diy-fluorometer/aolw2018-capetown/README.md

This repository holds everything we've done at the Advanced Open Labware Workshop, April 16 through April 27th in Capetown, South Africa
