diy-fluorometer/aolw2018-capetown/case/cad_files/README.md

All CAD files for the device case are stored here.

The design currently consists essentially of two nested boxes - an outer case that ensures light isolation, the inner case is where the LED, sensor, and LED are attached, and where the tube containing the sample will be inserted.
