diy-fluorometer/aolw2018-capetown/daily_reports/Day_08_2018-04-24.md

# Plan for the day

* Ale: Keep working on assembly instructions
* Lisa: Figure out bug in TSL2591 sensor code and fix it
* Do measurements with DNA ladder + fluorescent dye

# What we did today

## Bug in TSL2591 sensor code

The TSL2591 sensor offers four different gain settings:

| LOW    | 1x    |
| MEDIUM | 25x   |
| HIGH   | 428x  |
| MAX    | 9876x |

If there is very little light, the sensor might fail to return a value at the gain setting LOW, but a useable value at gain setting HIGH, for example. Under most conditions, the sensor returns useable values at several gain settings.
For example, when measuring with just the empty sensor box, we get the following values:

| Value | Gain level |
| -----:| --- |
| 14563 | MAX |
| 631 | HIGH |
| 37 | MED |
| 1 | LOW |

I thought it desirable to map the readings to a single scale, namely the one associated with the MAX gain setting. It turned out that the way I was trying to do that was wrong, hence the strange sensor readings. There's also not an easy fix, because there is no way you can map a value obtained at gain level LOW to a precise value on the MAX scale. Any value at LOW would map to entire range of values on the MAX scale.
So for today's measurements, I settled for recording the readings at all gain settings for each measurement and then sort through that data during the analysis stage.
One option would be to use the Lux calculation from the [Adafruit TSL2591 sensor library](https://github.com/adafruit/Adafruit_TSL2591_Library/blob/master/Adafruit_TSL2591.cpp). We can still do that later based on the data we have.
Note that we only record the data from the sensor's Channel 0 (IR+Visible), and ignore Channel 1 (IR).

## Measurements with DNA ladder + fluorescent dye

## Pulsing LED / Cellphone-only approach

Since the measurements with the textmarker where promissing we assembled the circuit described on day 5 withing an old fluorometer-housing. 
to measure the dilution series Roberts cell phone (Huawei P10) was connected to the "Cell-phone-only-fluorometer". To play the frequency the LED is modulatred with we used the signal generator app:(https://play.google.com/store/apps/details?id=com.xyz.signal). It can keep playing even if an other app is opened (see settings). 
The frequency was randomly chosen to be 479 Hz and therefore not coincide with overtones of the power grid. We used a sine since it appaered to have a slightly better signal to noise ratio.

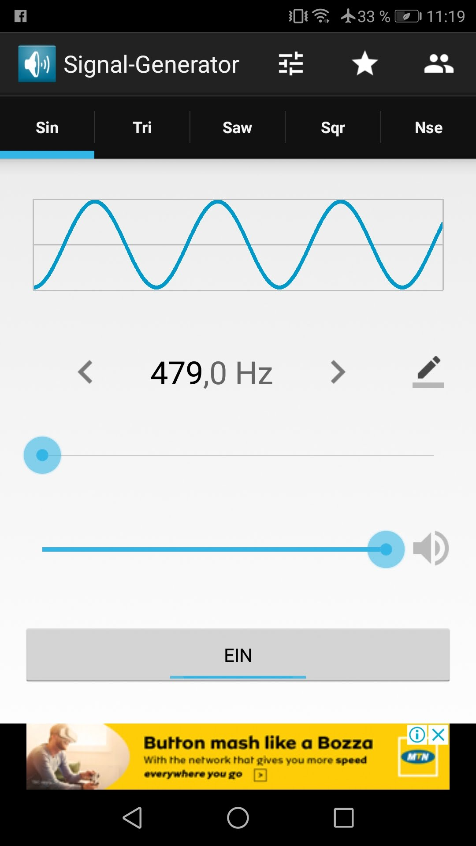
[picture p3: sketches/Screenshot_20180425-111908.jpg]
settings in the signal generator app to modulate the LED


To measure the Signal we used the FFT app: (https://play.google.com/store/apps/details?id=org.intoorbit.spectrum)

The seettings where chosen as seen in the screenshot:

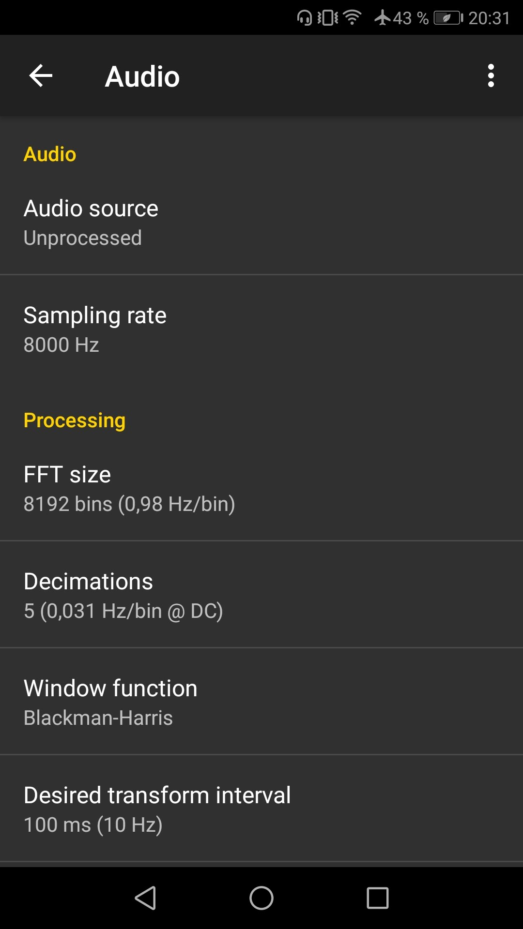
[picture p4: sketches/Screenshot_20180423-203127.jpg]
settings in the spectroid app to meassure the fluorescence signal


The dilution series was measured in total 6 times. Inbetween m1 and the rest of the measurements i dissassembled the setup and pulsed the LED with an Arduino. I thought this would improve the SNR. However it did not and instead the signal was fluctuating much more. I still have to figure out why.
I changed the setup to the initial conditions and tried to replicate the results of m1. I also took 5 values (m2-m6) to get a grasp of the fluctuations of the values. 

DNA ledders / µl | DNA ledders staing in tube / µl | DNA concentration µg/ml | initial H2O | Dye stock | total DNA in 50 µl/ ng | m 1 | m2 | m3 | m4 | m5 | m6 | m ard
 ---:  |  ---  |  ---  |  ---  |  ---  |  ---  |  ---  |  ---  |  ---  |  ---  |  ---  |  ---  |  --- 
80 | 40 | 160 | 0 | 10 | 8000 | -38.8067 | -38.6284 | -38.629 | -38.6422 | -38.6216 | -38.6246 | -13.882
40 | 20 | 80 | 40 | 10 | 4000 | -40.9717 | -40.6646 | -40.6417 | -40.6131 | -40.5897 | -40.5588 | -15.297
20 | 10 | 40 | 40 | 10 | 2000 | -42.8331 | -42.9878 | -42.9663 | -42.9723 | -42.9769 | -42.986 | -17.11
10 | 5 | 20 | 40 | 10 | 1000 | -43.9894 | -44.1098 | -44.1039 | -44.1069 | -44.108 | -44.1125 | -18.18
5 | 2.5 | 10 | 40 | 10 | 500 | -44.6641 | -44.6472 | -44.645 | -44.6418 | -44.643 | -44.6411 | -18.582
2.5 | 1.25 | 5 | 40 | 10 | 250 | -44.4905 | -44.5315 | -44.5255 | -44.5245 | -44.5232 | -44.5224 | -18.15
1.25 | 0.625 | 2.5 | 40 | 10 | 125 | -44.7322 | -44.6136 | -44.6188 | -44.6145 | -44.6128 | -44.6062 | -18.485
0.625 | 0.3125 | 1.25 | 40 | 10 | 62.5 | -44.7334 | -44.5895 | -44.5834 | -44.5792 | -44.5808 | -44.5798 | -18.394
0 | 0 | 0 | 40 | 10 | 0 | -44.9721 | -44.772 | -44.7697 | -44.7715 | -44.7713 | -44.7726 | -18.629

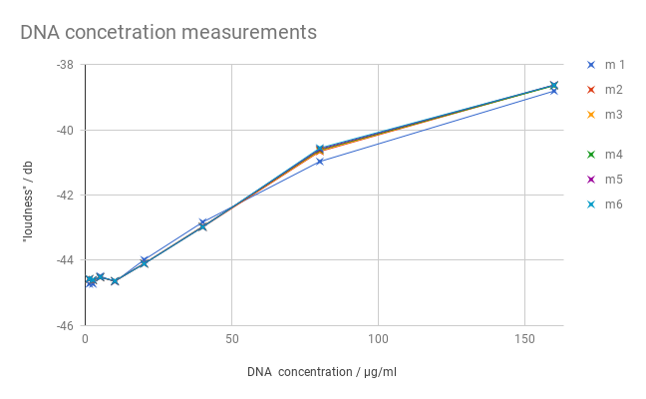
[picture p5: sketches/chart_dna_cell.png]
loudnes of the 479 Hz peak in dependence of the DNA concentration


Replicating worked well and the fluctuations are negligible.

The approach with the arduino should have given a better SNR. Indeed the max value of the peak was much higher. However it also  introduced signal fluctuations.
