diy-fluorometer/aolw2018-capetown/daily_reports/Day_09_2018-04-25.md

# Plan for the day

* Ale: Finish assembly instructions
* Lisa & Robert: Yesterday's documentation
* Analyze data from yesterday's measurements
* Do measurements of yesterday's samples with other filters
* Do measurements with other dyes: dsGreen, Pico488

# What we did today

## Small tasks

* Added BOM to repo

## Lessons learned / Observations / Future work

* Case use notes -> redesign
* Lambda DNA instead of DNA ladder?
* Buffer?
* Method for making the standard?
* Calibrating with text marker dye?
* Improve the circuit for the cellphone version
* Measure filters
* Improve NodeMCU code version
* DNA extraction & measurement of actual DNA
