diy-fluorometer/aolw2018-capetown/daily_reports/Day_06_2018-04-21.md

# Plan for the day

Today is only a half-day, so the task list is a bit shorter:

* Lisa will continue to work on the NodeMCU code
* Robert will continue to work on the cellphone-only version
* Editing photos from the assembly photo series; write out assembly instructions
* Robert: Cut glass filters
