diy-fluorometer/aolw2018-capetown/notes/use_notes.md

# Things we noticed while using the prototype

The design as it is is quite awkward. We already knew it's unnecessarily huge, but the sample holder is also positioned too low, which makes it awkward to put in the sample tubes, and to get them out again.
Desperately needs a redesign.
