diy-fluorometer/aolw2018-capetown/case/cad_files/IMPORTANT NOTE FOR LASERCUTTING.txt

Inkscape puts the line to cut a the border of the line.
Thus, to lasercut precuisely, you need to have lines of width 0.

The setup:
View -> display mode -> outline
