diy-fluorometer/aolw2018-capetown/docs/DNA_Quantification_Using_SYBR_Green_and_a_Micro-Plate_Reader.pdf

Purpose

To quantify purifi ed total double-stranded (ds) DNA by fl uorescence.

Equipment and Reagents

Equipment

1. Micro-plate reader (e.g. TECAN - M200 96-well plate reader).

Materials

1. 96-well black plate (e.g. Greiner – 96-well plate, black. VWR cat # 82050-784).

Reagents

1. 1x TE (10mM Tris HCI, 1mM• EDTA, pH8).
(i) Store at room temperature.
2. SYBR Green I dye (Invitrogen cat # S7563).
i) 100x working stock prepared by diluting 10 μL of SYBR Green dye with 990 μL TE buff er. ii) Store in 10 or 20 μL aliquots in 0.2 mL PCR tubes at -20°C.
iii) Before each use, thaw at room temperature.
3. dsDNA for Standard Curve – Lambda DNA (Invitrogen cat # 25250-010).
i) Serially dilute the DNA to give a total of 7 dilutions plus a no-DNA point.
ii) 50 μl aliquots of each standard are stored in 0.2 mL PCR tubes at - 20ºC (See table 2. Standards A-H). iii) Th aw one tube of each standard.

Procedure

### 1. Preparation of Master Mix

i) Prepare a master mix solution, suffi cient for all tubes to be assayed.

## DNA Quantifi cation Using SYBR Green I Dye and a Micro-Plate Reader

| Volume (μL) | 20 + n n=number of unknown samples
TE | 94
100X SYBR Green 1 | 1
Total | 95

Table 1.

### 2. Standard Curve:

i) For each standard (A-H):
(a) In duplicate, add 5 μL of each standard to a well of a black 96-well plate.
(b) Add 95 μl of the master mix to each well.

### 3. Unknown Purifi ed Saliva Samples

i) For each unknown sample(n):
(a) Dilute purifi ed DNA 1:50 in 1x TE (4 μL sample + 196 μL 1x TE).
(b) Add 5 μL of unknown sample to a well of a black 96-well plate.
(c) Add 95 μL of Master Mix.

### 4. Read Fluorescence of Samples

(a) Excitation 485 nM.
(b) Emission 535 nM.

### Safety and Environmental Information

Th e use of gloves is required to avoid sample contamination.

### END OF PROCEDURE

PD-PR-075 Issue 1.0
info@dnagenotek.com
Tel.: (613)723-5757
Standard | Concentration (ng/μl) | Volume (μl) | Total DNA (ng)
A | 10.0 | 5 | 50.0
B | 5.0 | 5 | 25.0
C | 2.51 | 5 | 12.5
D | 1.25 | 5 | 6.25
E | 0.625 | 5 | 3.12
F | 0.3125 | 5 | 1.56
G | 0.156 | 5 | 0.78
H | 0.0 | 5 | 0.0
Table 2.
