diy-fluorometer/aolw2018-capetown/analysis/chart_cell_arduino.png

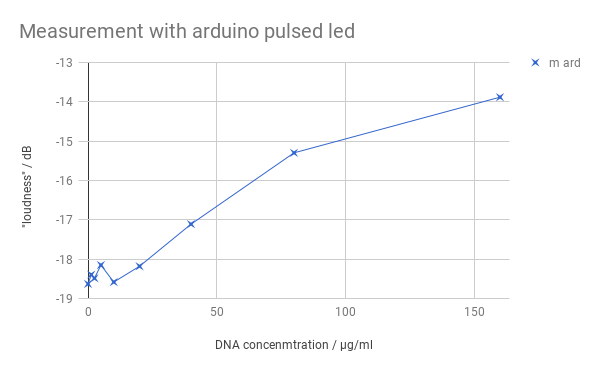
analysis/chart_cell_arduino.png
