diy-fluorometer/aolw2018-capetown/analysis/DNA_cheek_cell.png

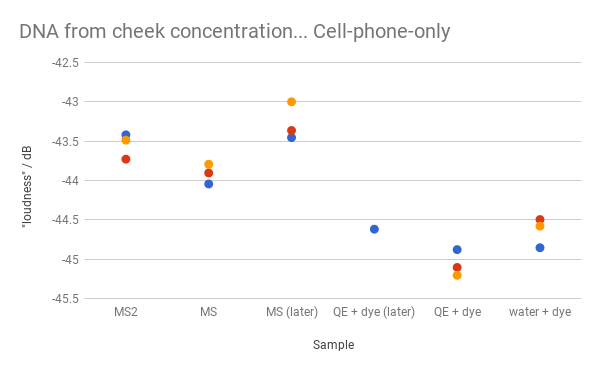
analysis/DNA_cheek_cell.png
