diy-fluorometer/aolw2018-capetown/daily_reports/photos/P1030807.JPG

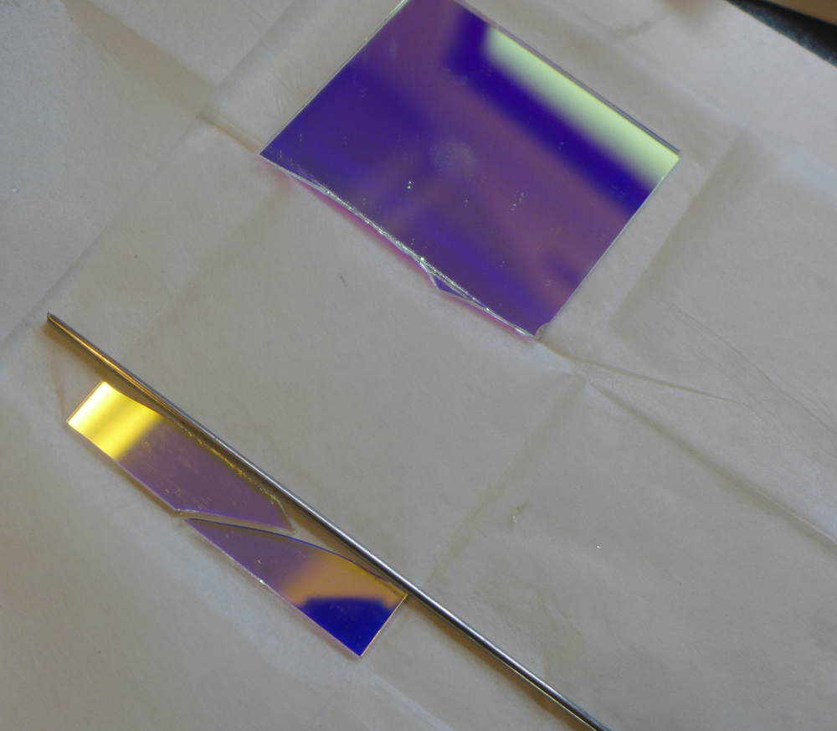
daily_reports/photos/P1030807.JPG
