diy-fluorometer/aolw2018-capetown/daily_reports/photos/P1030809.JPG

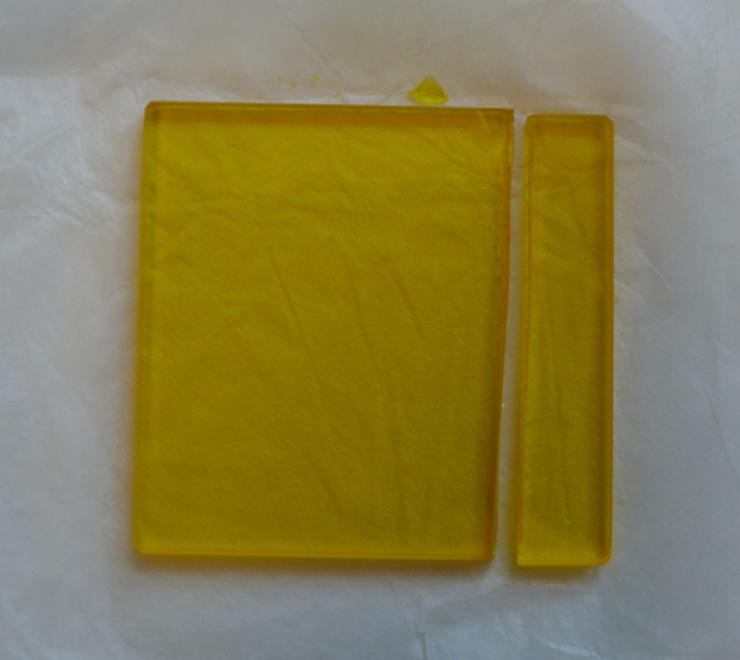
daily_reports/photos/P1030809.JPG
