diy-fluorometer/aolw2018-capetown/daily_reports/photos/P1030810.JPG

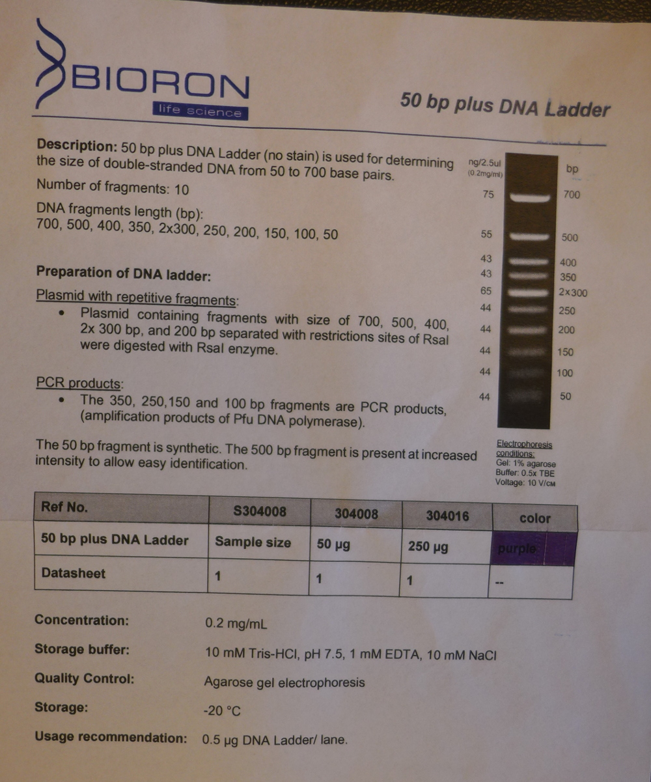
daily_reports/photos/P1030810.JPG
