diy-fluorometer/aolw2018-capetown/daily_reports/photos/P1030812.JPG

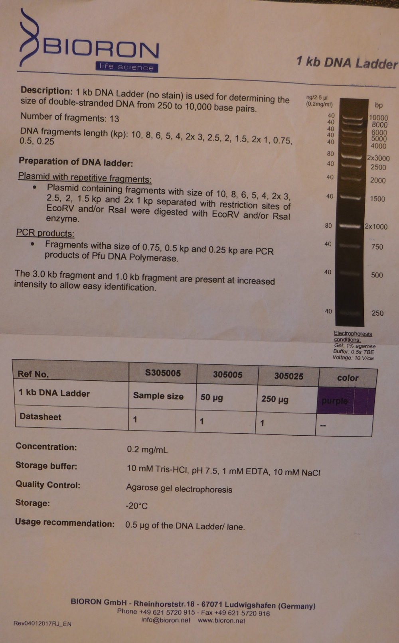
daily_reports/photos/P1030812.JPG
