diy-fluorometer/aolw2018-capetown/daily_reports/photos/P1030813.JPG

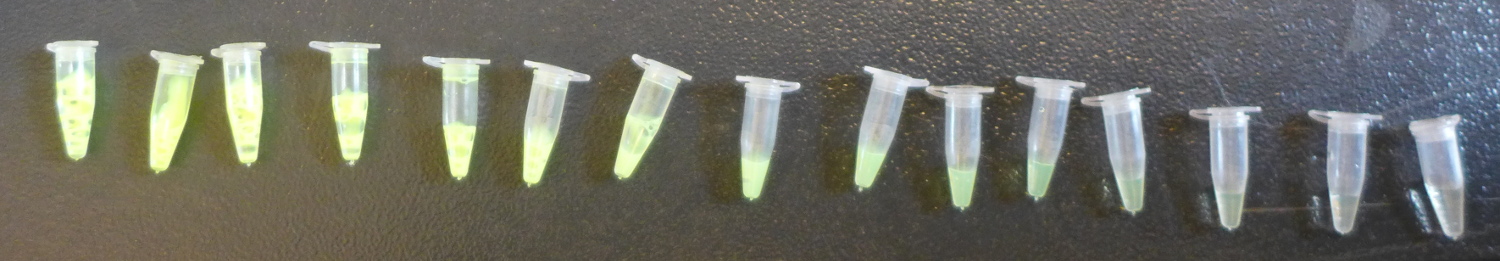
daily_reports/photos/P1030813.JPG
