diy-fluorometer/aolw2018-capetown/docs/assembly/edited/overview.JPG

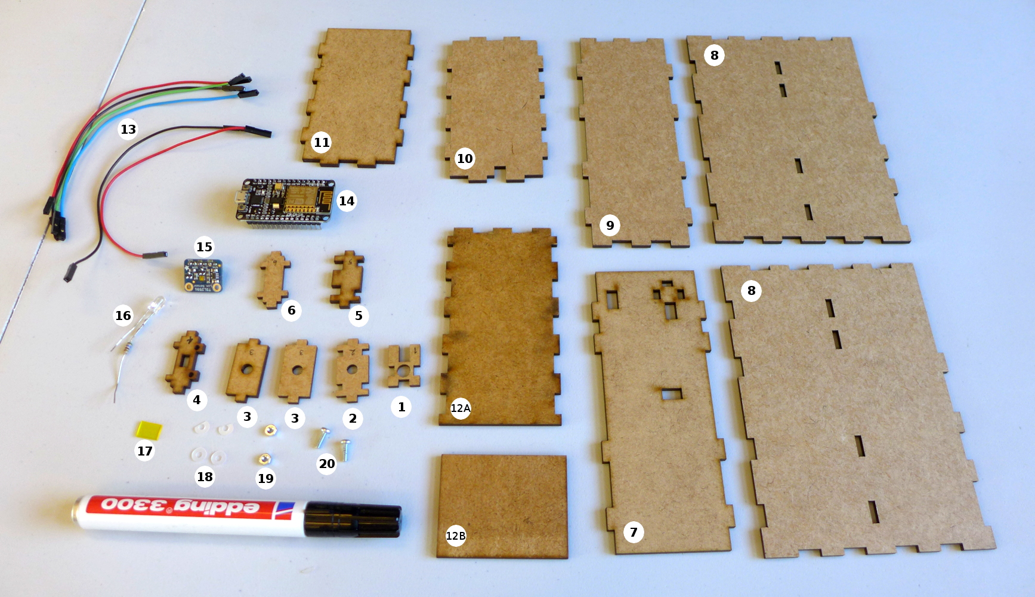
docs/assembly/edited/overview.JPG
