diy-fluorometer/aolw2018-capetown/docs/TSL2591_dimensions.png

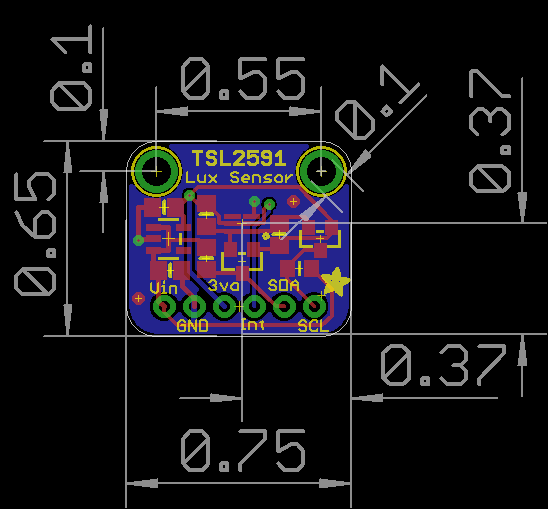
docs/TSL2591_dimensions.png
