diy-fluorometer/aolw2018-capetown/docs/TSL2591_NodeMCU_schem.png

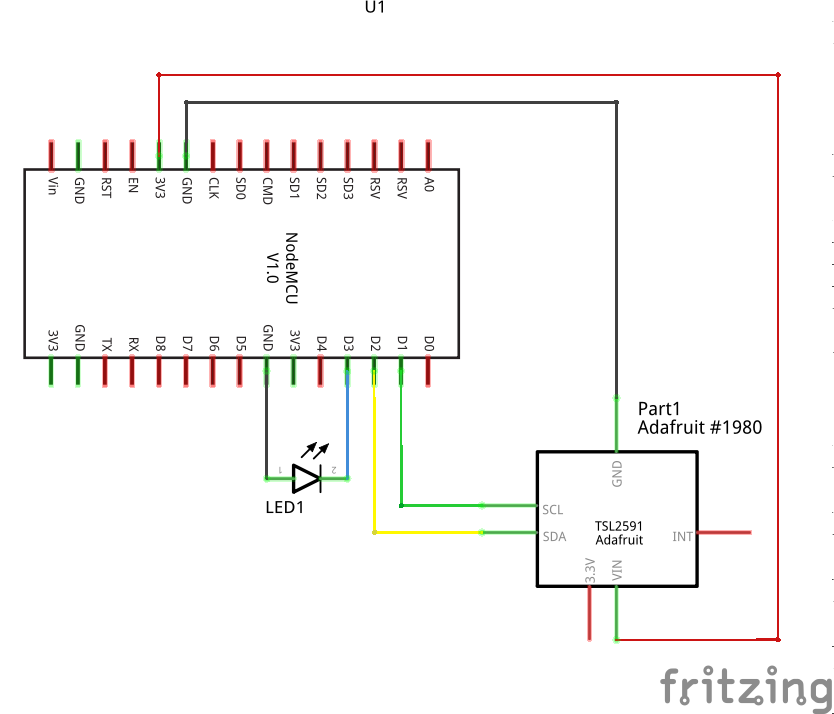
docs/TSL2591_NodeMCU_schem.png
