diy-fluorometer/aolw2018-capetown/sketches/IMG-20180513-WA0001.jpg

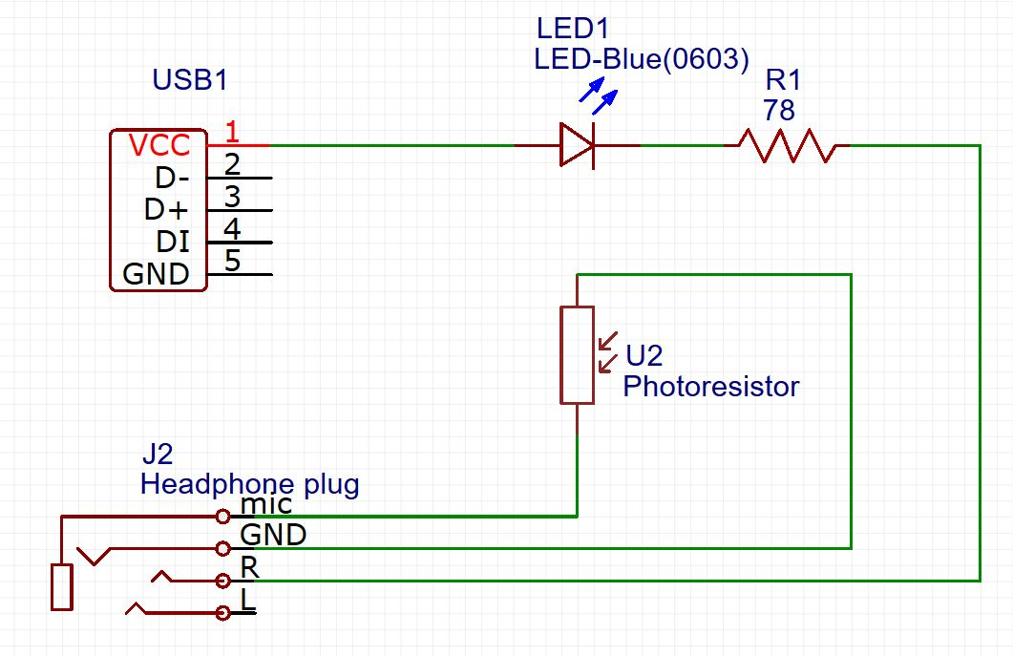
sketches/IMG-20180513-WA0001.jpg
