diy-fluorometer/aolw2018-capetown/sketches/IMG_20180427_130239.jpg

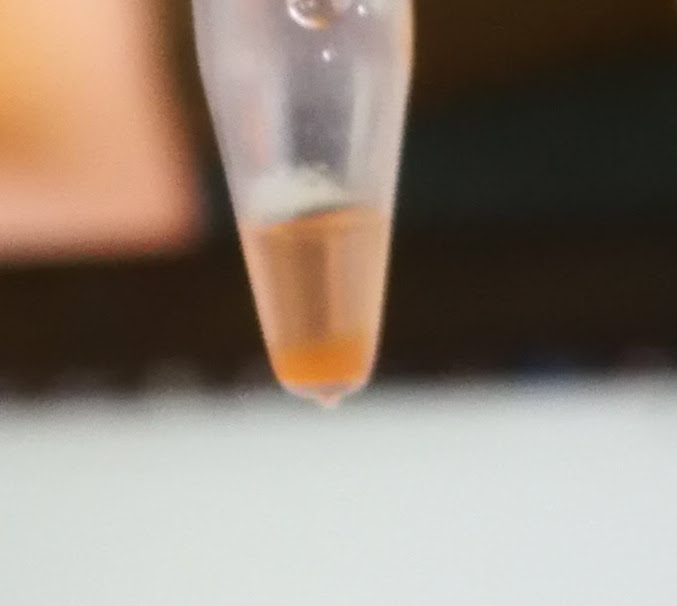
sketches/IMG_20180427_130239.jpg
