diy-fluorometer/aolw2018-capetown/case/cad_files/v5/test3_sub4.dxf

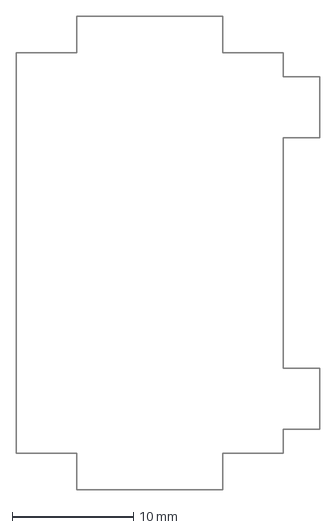
[picture p23: CAD file, 2018-07-02]
case/cad_files/v5/test3_sub4.dxf
25.0 x 39.0 mm
