diy-fluorometer/aolw2018-capetown/case/cad_files/v5/test3_sub.dxf

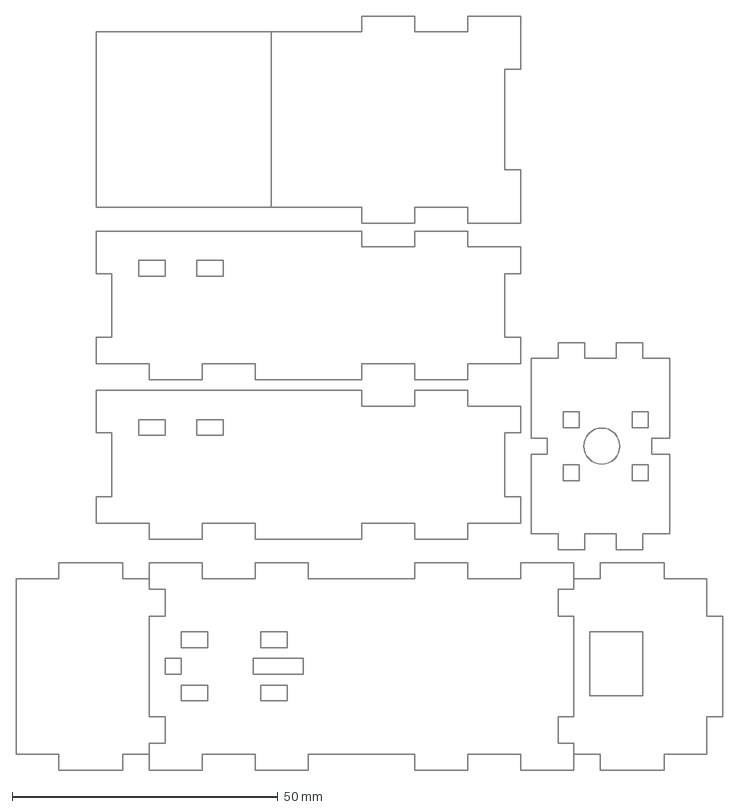
[picture p24: CAD file, 2018-07-02]
case/cad_files/v5/test3_sub.dxf
133.0 x 142.0 mm
