diy-fluorometer/aolw2018-capetown/case/cad_files/v5/test2_mod1.dxf

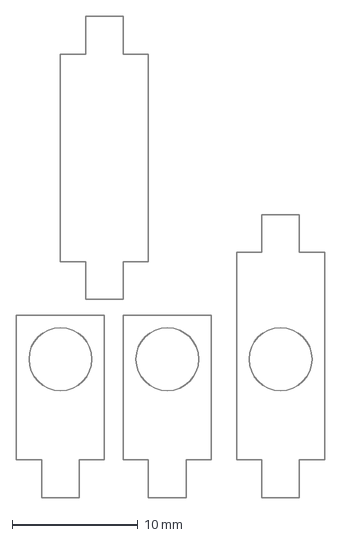
[picture p25: CAD file, 2018-07-02]
case/cad_files/v5/test2_mod1.dxf
24.5 x 38.2 mm
