diy-fluorometer/aolw2018-capetown/case/cad_files/v5/test3_sub2.dxf

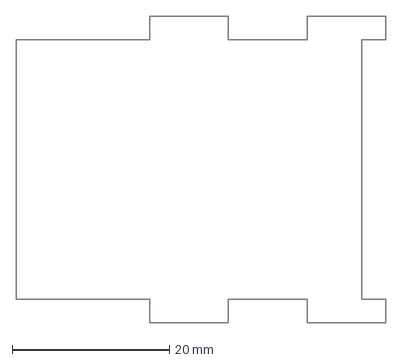
[picture p26: CAD file, 2018-07-02]
case/cad_files/v5/test3_sub2.dxf
47.0 x 39.0 mm
