diy-fluorometer/aolw2018-capetown/case/cad_files/v5/test3.dxf

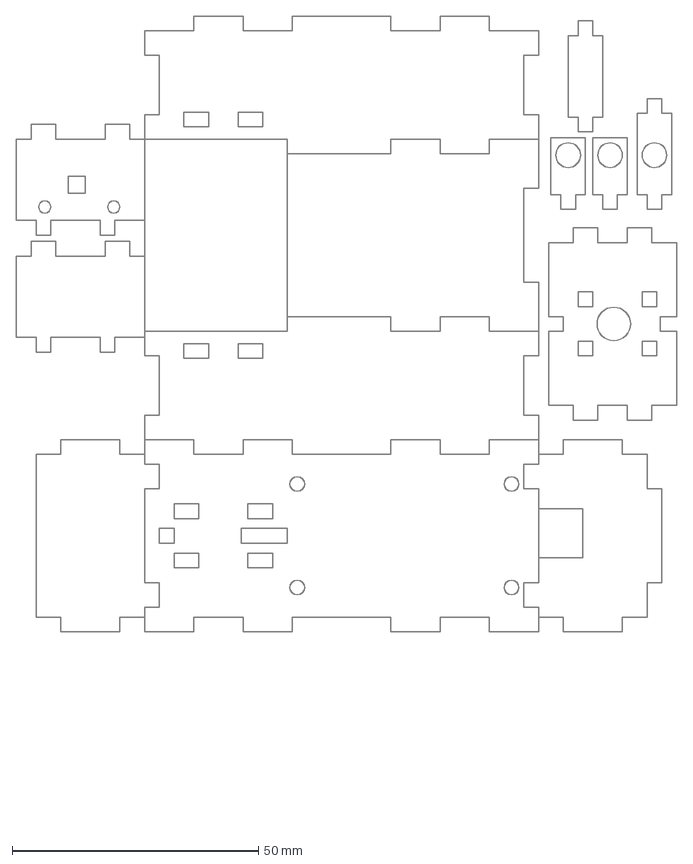
[picture p27: CAD file, 2018-07-02]
case/cad_files/v5/test3.dxf
134.0 x 164.0 mm
