diy-fluorometer/aolw2018-capetown/case/cad_files/v5/test3m.dxf

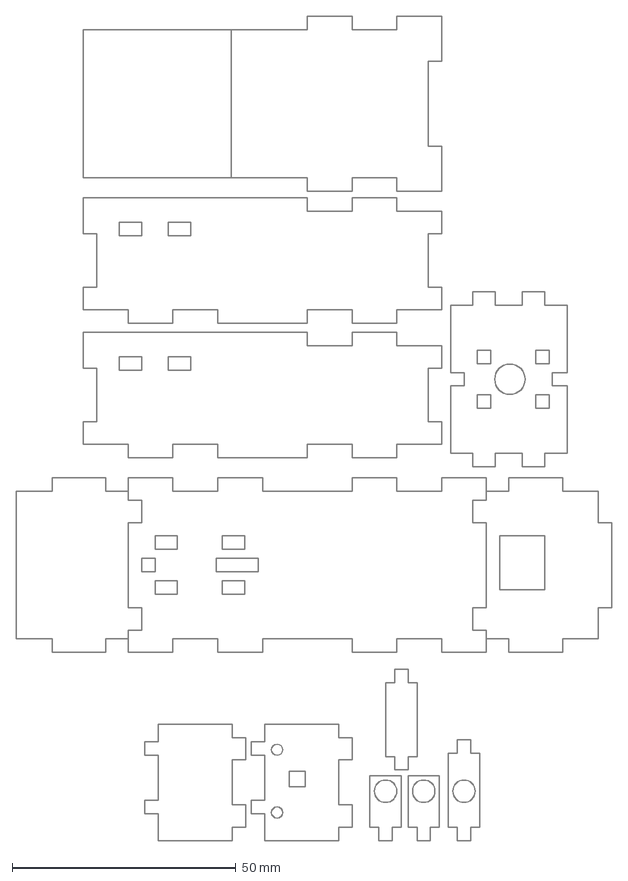
[picture p28: CAD file, 2018-07-02]
case/cad_files/v5/test3m.dxf
133.0 x 184.0 mm
