diy-fluorometer/aolw2018-capetown/case/cad_files/v5/test1.dxf

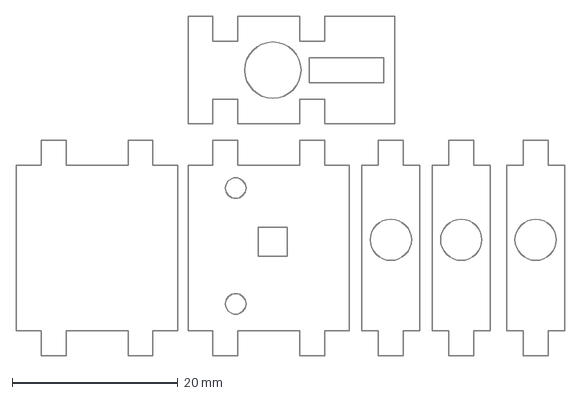
[picture p29: CAD file, 2018-07-02]
case/cad_files/v5/test1.dxf
66.2 x 41.0 mm
