diy-fluorometer/aolw2018-capetown/case/cad_files/v5/test2.dxf

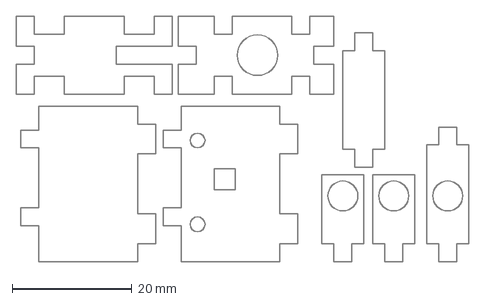
[picture p30: CAD file, 2018-07-02]
case/cad_files/v5/test2.dxf
75.5 x 41.0 mm
