diy-fluorometer/aolw2018-capetown/case/cad_files/v5/test3_sub3.dxf

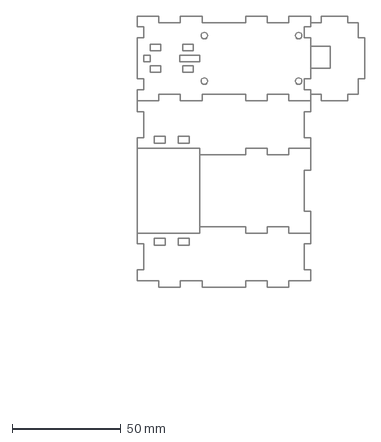
[picture p31: CAD file, 2018-07-02]
case/cad_files/v5/test3_sub3.dxf
160.7 x 177.8 mm
