diy-fluorometer/aolw2018-capetown/case/cad_files/v5/test3_sub5.dxf

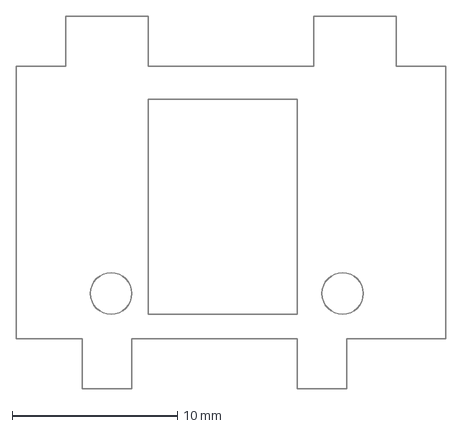
[picture p32: CAD file, 2018-07-02]
case/cad_files/v5/test3_sub5.dxf
26.0 x 22.5 mm
