diy-fluorometer/aolw2018-capetown/case/cad_files/v4/add_7.dxf

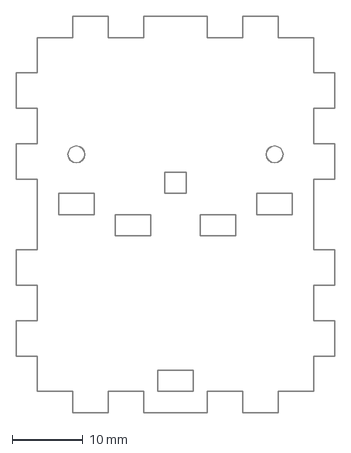
[picture p33: CAD file, 2018-05-15, an earlier design]
case/cad_files/v4/add_7.dxf
45.0 x 56.0 mm
