diy-fluorometer/aolw2018-capetown/case/cad_files/v4/add_5.dxf

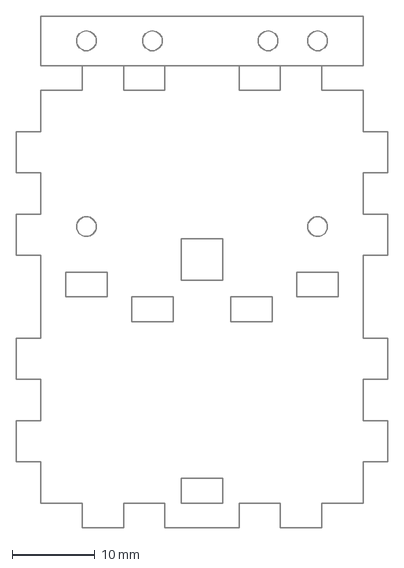
[picture p34: CAD file, 2018-05-15, an earlier design]
case/cad_files/v4/add_5.dxf
45.0 x 62.0 mm
