diy-fluorometer/aolw2018-capetown/case/cad_files/v4/v4_1.dxf

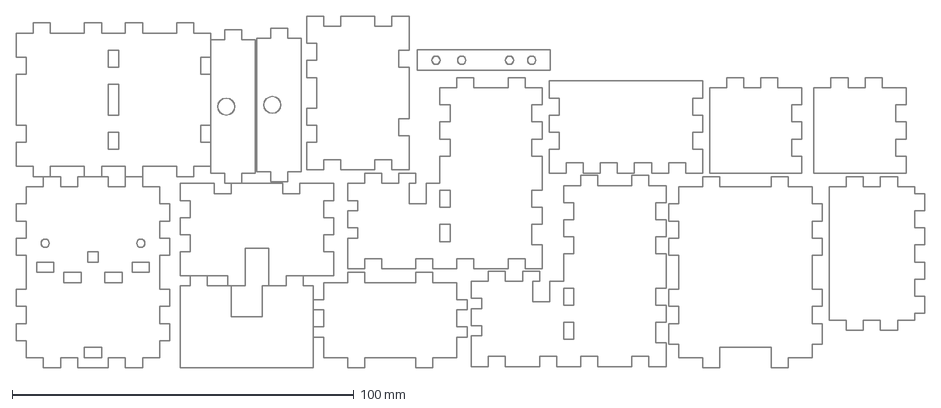
[picture p35: CAD file, 2018-05-15, an earlier design]
case/cad_files/v4/v4_1.dxf
266.0 x 103.0 mm
