diy-fluorometer/aolw2018-capetown/case/cad_files/v4/add_6.dxf

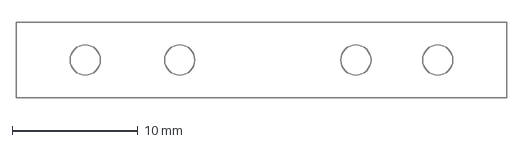
[picture p36: CAD file, 2018-05-15, an earlier design]
case/cad_files/v4/add_6.dxf
39.0 x 6.00 mm
