diy-fluorometer/aolw2018-capetown/case/cad_files/v4/cuvette_bodyx3.dxf

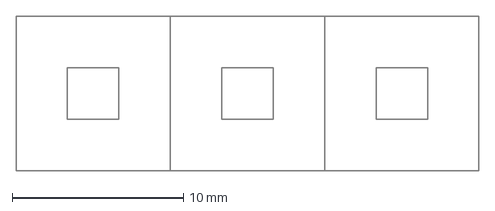
[picture p38: CAD file, 2018-05-13, an earlier design]
case/cad_files/v4/cuvette_bodyx3.dxf
27.0 x 9.00 mm
