diy-fluorometer/aolw2018-capetown/case/cad_files/v4/add_2.dxf

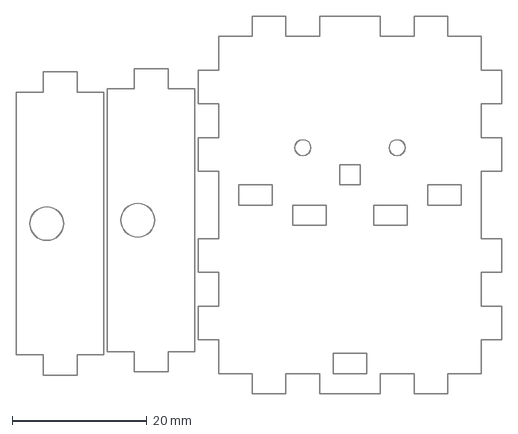
[picture p39: CAD file, 2018-05-13, an earlier design]
case/cad_files/v4/add_2.dxf
72.0 x 56.0 mm
