diy-fluorometer/aolw2018-capetown/case/cad_files/v4/cuvette_basex20.dxf

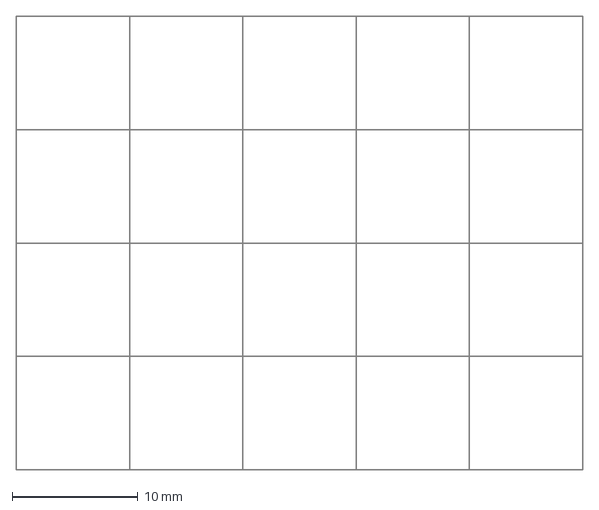
[picture p40: CAD file, 2018-05-13, an earlier design]
case/cad_files/v4/cuvette_basex20.dxf
45.0 x 36.0 mm
