diy-fluorometer/aolw2018-capetown/(list of files, cad)

Other CAD files:
case/cad_files/v4/v4.scad
case/cad_files/v4/add.dxf
