diy-fluorometer/aolw2018-capetown/docs/assembly/edited/P1030792.JPG

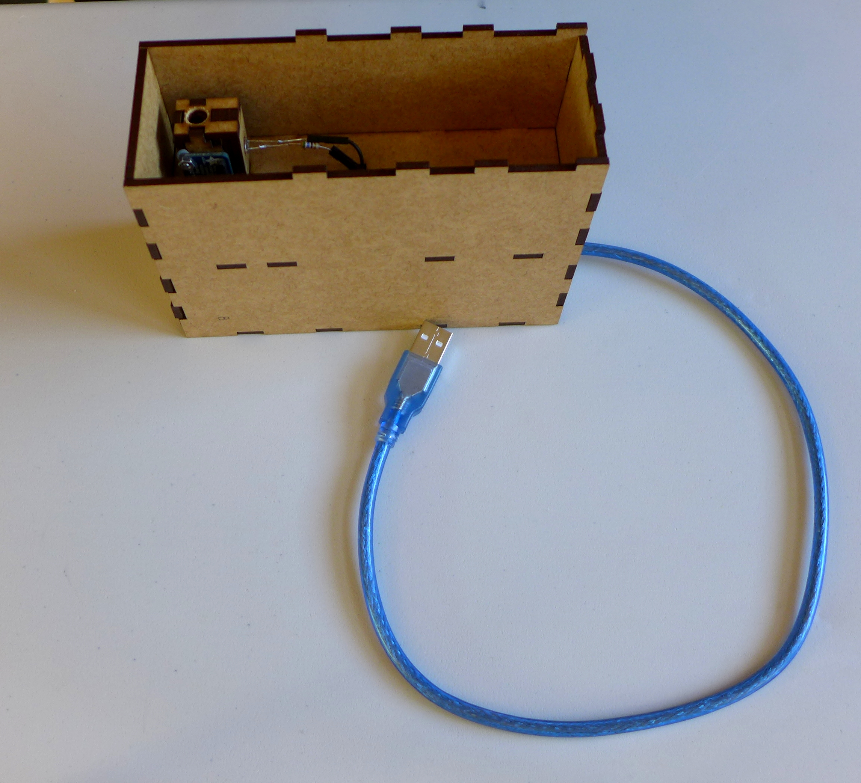
docs/assembly/edited/P1030792.JPG
