diy-fluorometer/aolw2018-capetown/docs/assembly/unedited/P1030760.JPG

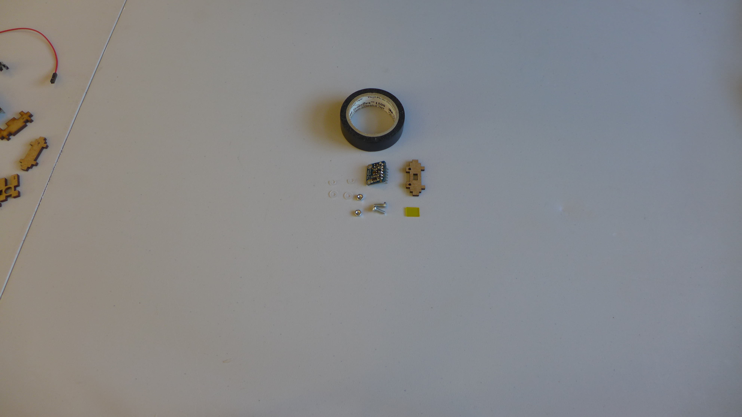
docs/assembly/unedited/P1030760.JPG
