diy-fluorometer/aolw2018-capetown/docs/assembly/unedited/P1030764.JPG

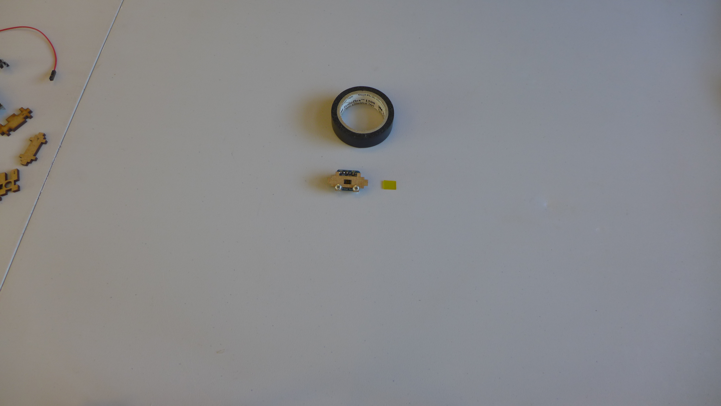
docs/assembly/unedited/P1030764.JPG
