diy-fluorometer/aolw2018-capetown/docs/assembly/unedited/P1030768.JPG

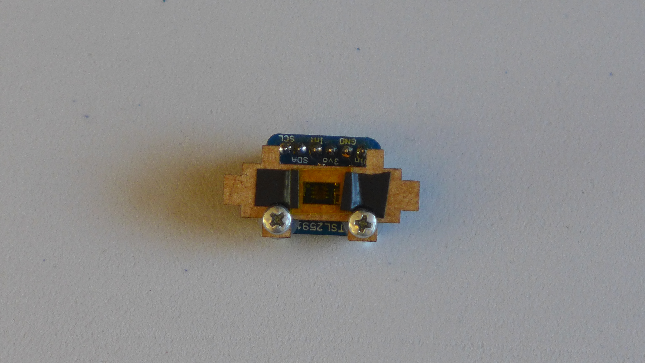
docs/assembly/unedited/P1030768.JPG
