diy-fluorometer/aolw2018-capetown/docs/assembly/unedited/P1030770.JPG

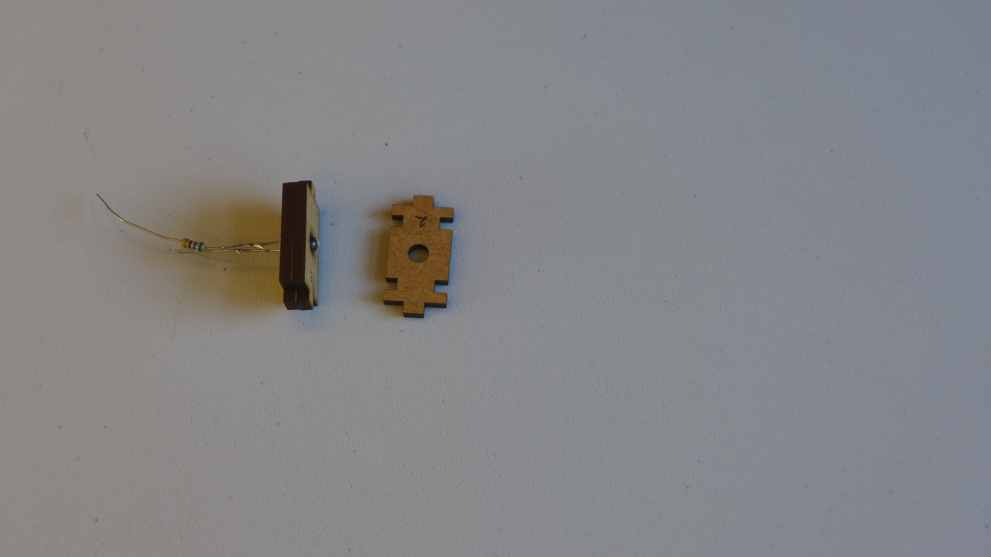
docs/assembly/unedited/P1030770.JPG
