diy-fluorometer/aolw2018-capetown/docs/assembly/unedited/P1030774.JPG

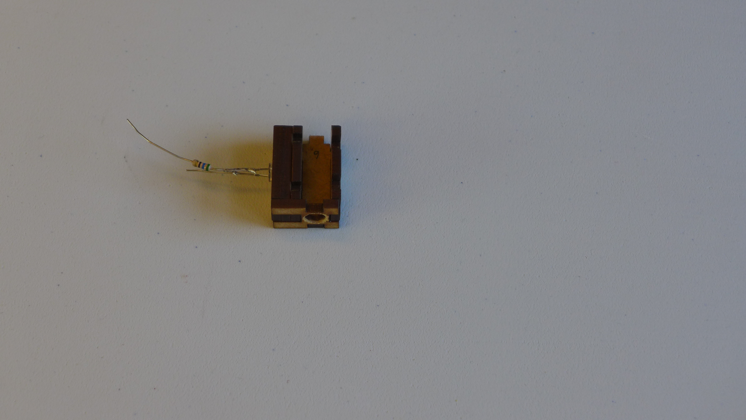
docs/assembly/unedited/P1030774.JPG
