diy-fluorometer/aolw2018-capetown/docs/assembly/unedited/P1030775.JPG

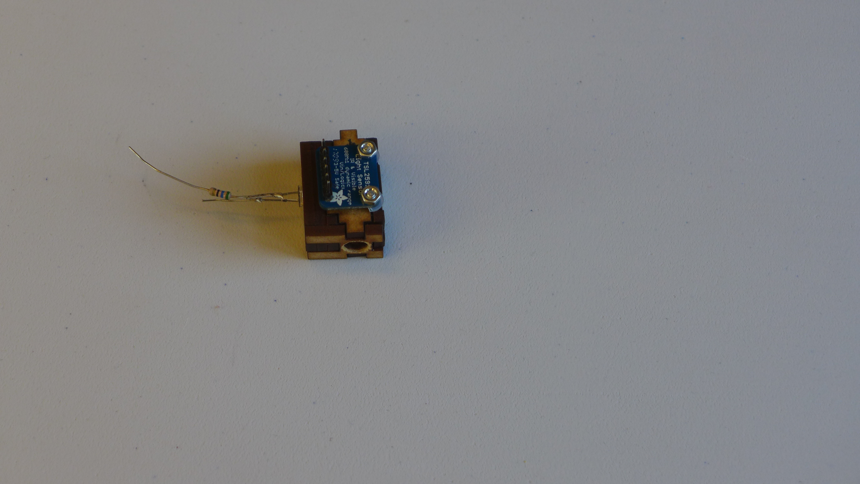
docs/assembly/unedited/P1030775.JPG
