diy-fluorometer/aolw2018-capetown/docs/assembly/unedited/P1030779.JPG

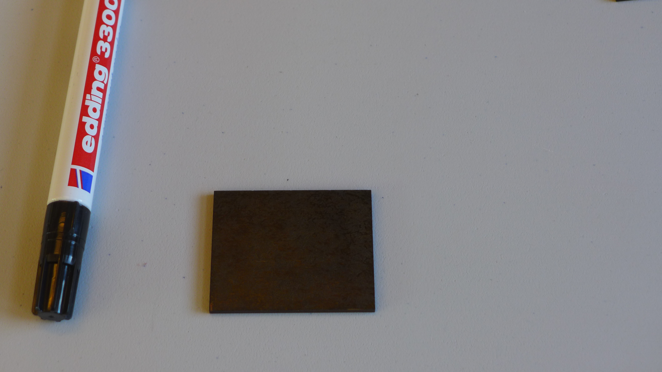
docs/assembly/unedited/P1030779.JPG
