diy-fluorometer/aolw2018-capetown/docs/assembly/unedited/P1030783.JPG

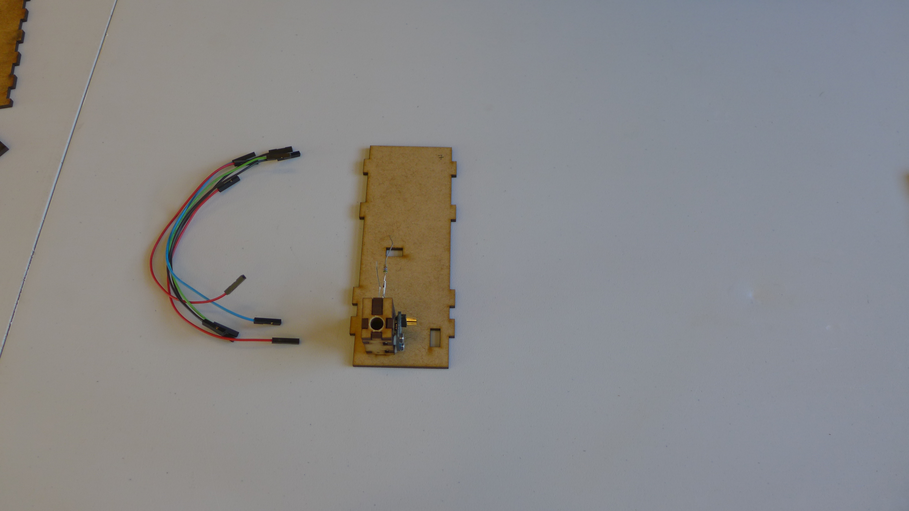
docs/assembly/unedited/P1030783.JPG
