diy-fluorometer/aolw2018-capetown/docs/assembly/unedited/P1030787.JPG

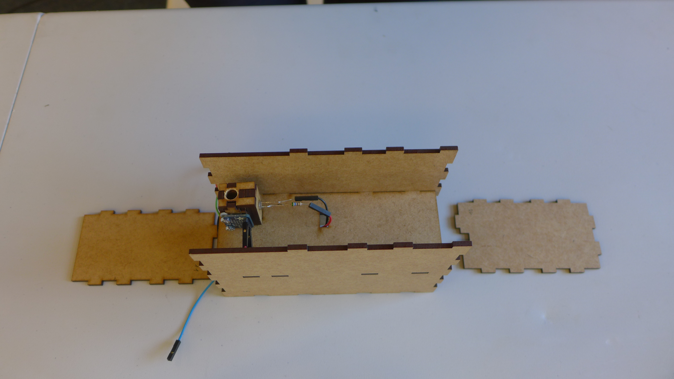
docs/assembly/unedited/P1030787.JPG
