diy-fluorometer/aolw2018-capetown/docs/assembly/unedited/P1030791.JPG

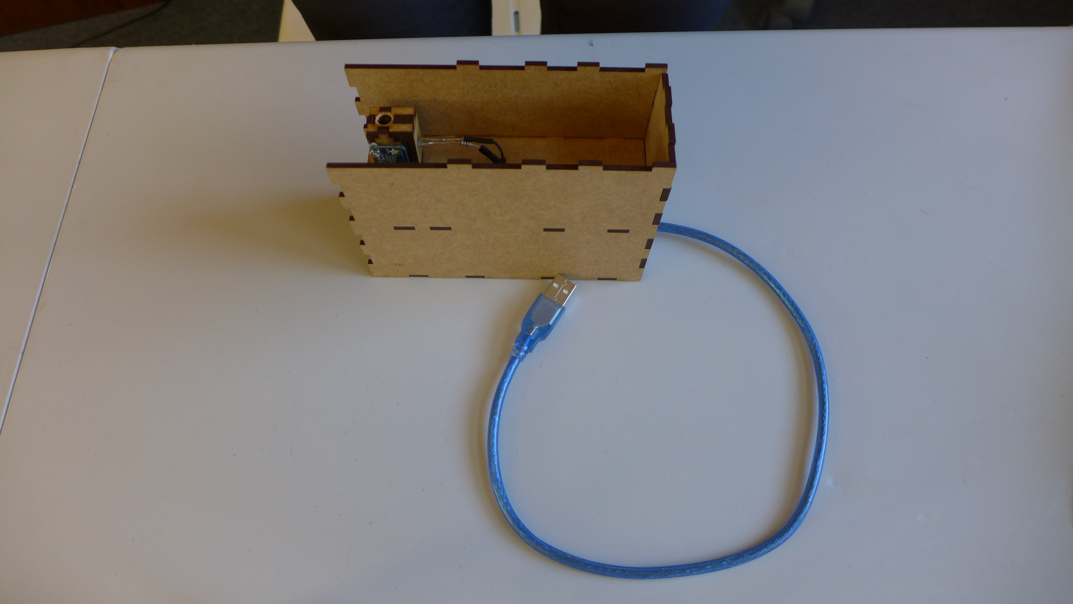
docs/assembly/unedited/P1030791.JPG
