diy-fluorometer/aolw2018-capetown/docs/assembly/unedited/P1030792.JPG

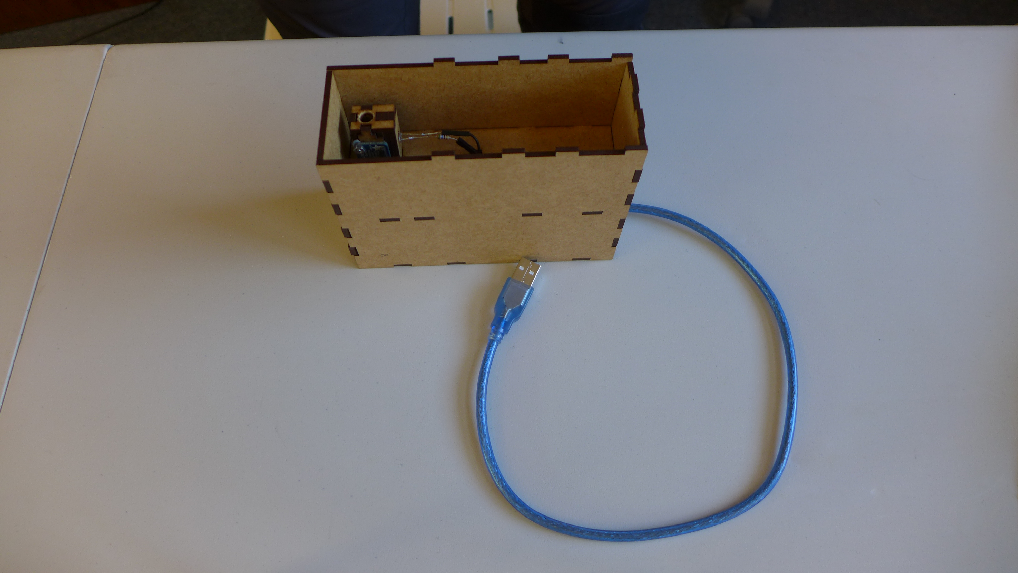
docs/assembly/unedited/P1030792.JPG
