diy-fluorometer/aolw2018-capetown/data/gain_test/S6_test.csv

MED S6 | 1 | 4750
LOW S6 | 1 | 198
MED S6 | 2 | 4760
LOW S6 | 2 | 198
MED S6 | 3 | 4765
LOW S6 | 3 | 198
MED S6 | 4 | 4770
LOW S6 | 4 | 198
MED S6 | 5 | 4772
LOW S6 | 5 | 198
MED S6 | 6 | 4775
LOW S6 | 6 | 199
MED S6 | 7 | 4776
LOW S6 | 7 | 199
MED S6 | 8 | 4777
LOW S6 | 8 | 199
MED S6 | 9 | 4780
LOW S6 | 9 | 199
MED S6 | 10 | 4781
LOW S6 | 10 | 199
