diy-fluorometer/aolw2018-capetown/data/gain_test/S7_test.csv

MED S7 | 1 | 4897
LOW S7 | 1 | 204
MED S7 | 2 | 4911
LOW S7 | 2 | 204
MED S7 | 3 | 4917
LOW S7 | 3 | 205
MED S7 | 4 | 4922
LOW S7 | 4 | 205
MED S7 | 5 | 4924
LOW S7 | 5 | 204
MED S7 | 6 | 4926
LOW S7 | 6 | 205
MED S7 | 7 | 4929
LOW S7 | 7 | 205
MED S7 | 8 | 4930
LOW S7 | 8 | 205
MED S7 | 9 | 4930
LOW S7 | 9 | 205
MED S7 | 10 | 4933
LOW S7 | 10 | 205
