diy-fluorometer/aolw2018-capetown/data/gain_test/S8_test.csv

MED test1 | 1 | 3869
LOW test1 | 1 | 161
MED test1 | 2 | 3877
LOW test1 | 2 | 161
MED test1 | 3 | 3883
LOW test1 | 3 | 162
MED test1 | 4 | 3886
LOW test1 | 4 | 162
MED test1 | 5 | 3889
LOW test1 | 5 | 161
MED test1 | 6 | 3892
LOW test1 | 6 | 162
MED test1 | 7 | 3892
LOW test1 | 7 | 162
MED test1 | 8 | 3894
LOW test1 | 8 | 162
MED test1 | 9 | 3896
LOW test1 | 9 | 162
MED test1 | 10 | 3898
LOW test1 | 10 | 162
