diy-fluorometer/aolw2018-capetown/data/gain_test/S9_test.tsv

GLOW | GMED | GHIGH | GMAX
137 | 3285 | 56657
137 | 3289 | 56728
137 | 3290 | 56742
137 | 3289 | 56706
136 | 3281 | 56584
136 | 3279 | 56522
136 | 3292 | 56758
136 | 3284 | 56615
137 | 3284 | 56635
136 | 3278 | 56555
136 | 3259 | 56157
136 | 3269 | 56341
137 | 3289 | 56706
137 | 3291 | 56746
137 | 3286 | 56666
137 | 3288 | 56735
136 | 3286 | 56681
137 | 3287 | 56691
136 | 3273 | 56397
136 | 3278 | 56487
