diy-fluorometer/aolw2018-capetown/notes/todo.md

# Random tasks that we would ideally get done during the workshop (or "future work"

Strike out any task below that you have completed.

* Assembly instructions for the case
* Make photos and possibly a 3D model of the finished case
* Describe the case and the design decisions that went into it
* Make a nice diagram of our dilution series with absolute volumes that we will be using and the corresponding concentrations
* Buffers for DNA quantification? Commercial kits include some kind of buffer...
