diy-fluorometer/aolw2018-capetown/(list of files, drawings)

Other design files:
docs/TSL2591_NodeMCU.fzz
