diy-fluorometer/aolw2018-capetown/(commit log)

2018-04-20 Raw images for the assembly instruction photo series
2018-04-23 Code changes (not done yet); first measurement series
    [2018-04-23_TextMarker_1.csv]
2018-04-23 second measurement series, after painting the inside of the tube holder black
    [2018-04-23_TextMarker_2.csv]
2018-04-24 more data, adjusted code to work with/around the gain control questions
    [2018-04-23_TextMarker_1.csv, 2018-04-23_TextMarker_2.csv, 2018-04-23_TextMarker_3.csv, S14_test.csv, S6_test.csv, S7_test.csv, S8_test.csv, S9_test.csv]
2018-04-24 Adding data from measurements with DNA ladder and GelGreen dye
    [2018-04-24_GelGreen_50bpladder_1.csv]
2018-04-25 Added BOM; cosmetic changes to record of first measurement series
    [2018-04-24_GelGreen_50bpladder_1.csv]
2018-04-25 Create a place to collect analyses
    [2018-04-24_GelGreen_50bpladder_1.csv]
2018-04-25 Added more measurement series; added some preliminary analysis; added a protocol for quantifying DNA using SYBR Green I for reference
    [2018-04-25_GelGreen_50bpladder_replica1.csv, 2018-04-25_GelGreen_50bpladder_replica2.csv]
2018-04-26 Moving assembly instructions to the docs/assembly directory
2018-04-27 Adding data and analysis for DNA extraction measurements; some edits to the assembly instructions
    [2018-04-26_GelGreen_QE_2_filters.csv, 2018-04-26_GelGreen_QE_2_replica1.csv, 2018-04-26_GelGreen_QE_replica1.csv]
2018-04-27 Replication measurements +24h for yesterday's experiment + some evaluation of the data; added another protocol for DNA quantification using SYBR Green I; started the final report
    [2018-04-27_GelGreen_QE_2_filters_plus24h.csv]
2018-05-04 some added analysis of different filter sets; continued work on the final report
    [2018-04-26_GelGreen_QE_2_filters.csv, 2018-04-28_510nm_dichroicglass_diff.csv, sampling_assembly.scad]
2018-05-13 more work on the final report; added a 3D model and CAD files for v4 based on what we learned at AOLW
    [add.dxf, add_2.dxf, cuvette_basex20.dxf, cuvette_bodyx3.dxf, v4.scad, v4_1.dxf]
2018-05-13 Added dimensions drawing from Adafruit for the TSL2591 lux sensor
2018-05-13 Added Fritzing diagram for TSL2591 version; added circuit for smartphone-version
    [TSL2591_NodeMCU.fzz]
2018-05-15 More work on final report
    [TSL2591_NodeMCU.fzz]
2018-05-15 Moved v4 3D model to the proper subdirectory
    [v4.scad]
2018-05-15 yes move
    [v4.scad]
2018-05-15 worked on the v4 case today; minor corrections in the final report
    [add_3.dxf, add_5.dxf, add_6.dxf, add_7.dxf, v4_1.dxf]
2018-06-05 Making a simple but user-friendly interface for Lange Nacht der Wissenschaften
2018-07-02 CAD files for v5 case; code changes for WiFi version; preparing some v5 measurements
    [TextMarker_1.csv, TextMarker_2.csv, TextMarker_3.csv, test1.dxf, test2.dxf, test2_mod1.dxf, test3.dxf, test3_sub.dxf]
